maxwellmbooth/eeerover/board/age.png

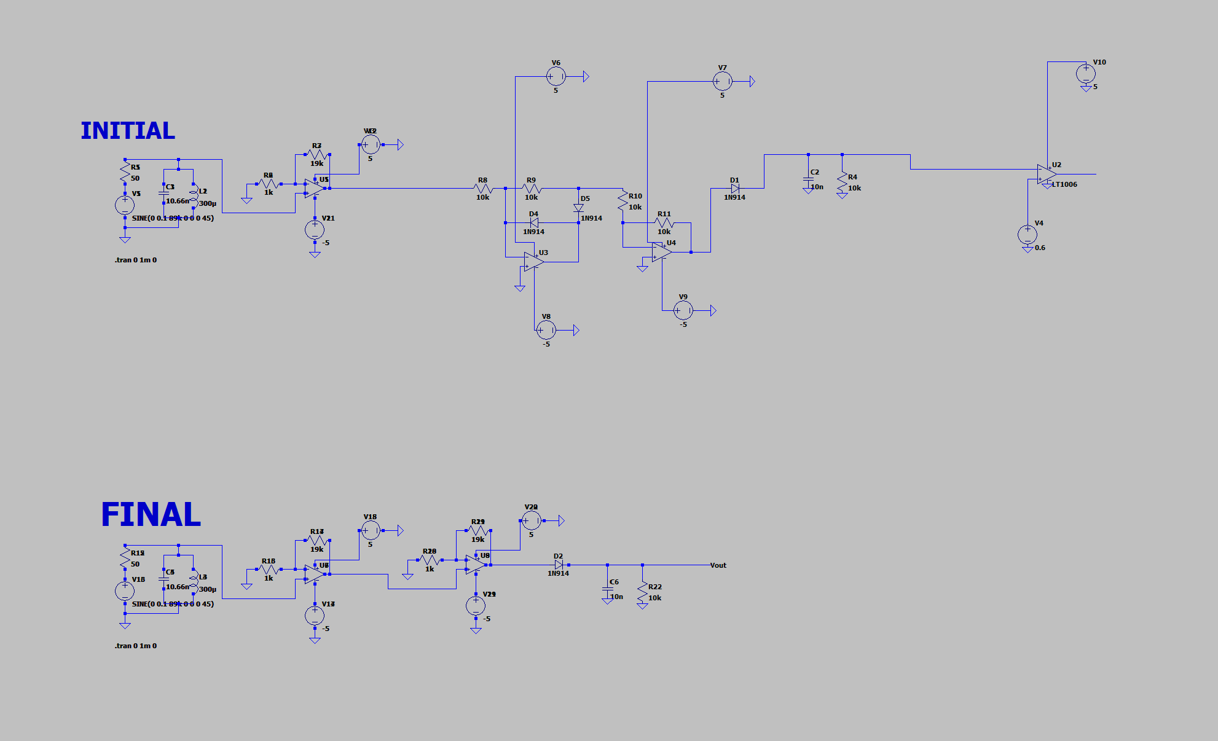
board/age.png
