maxwellmbooth/eeerover/board/ir.png

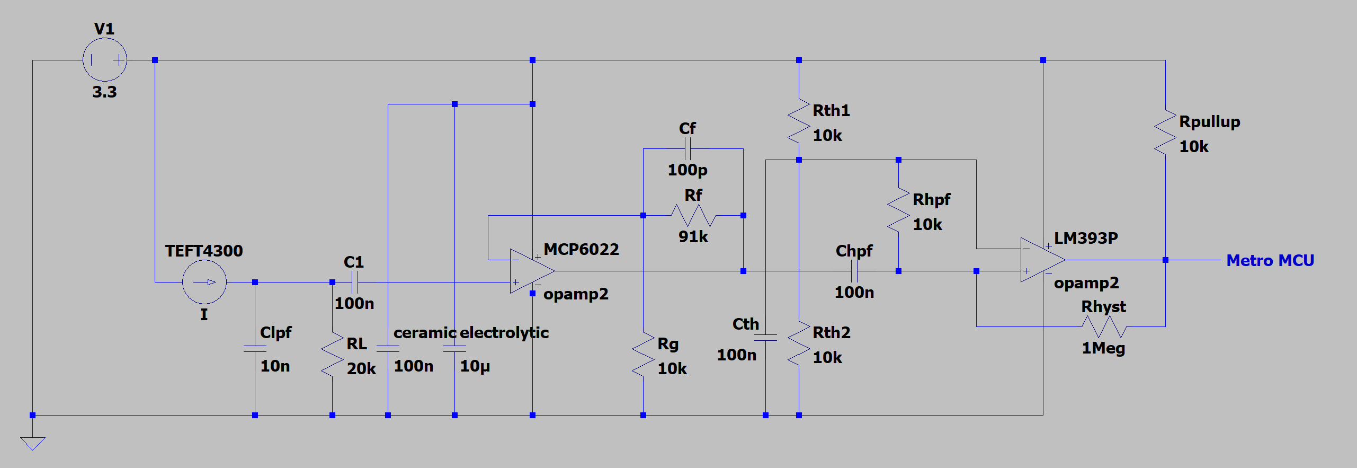
board/ir.png
