maxwellmbooth/eeerover/board/ultrasound.png

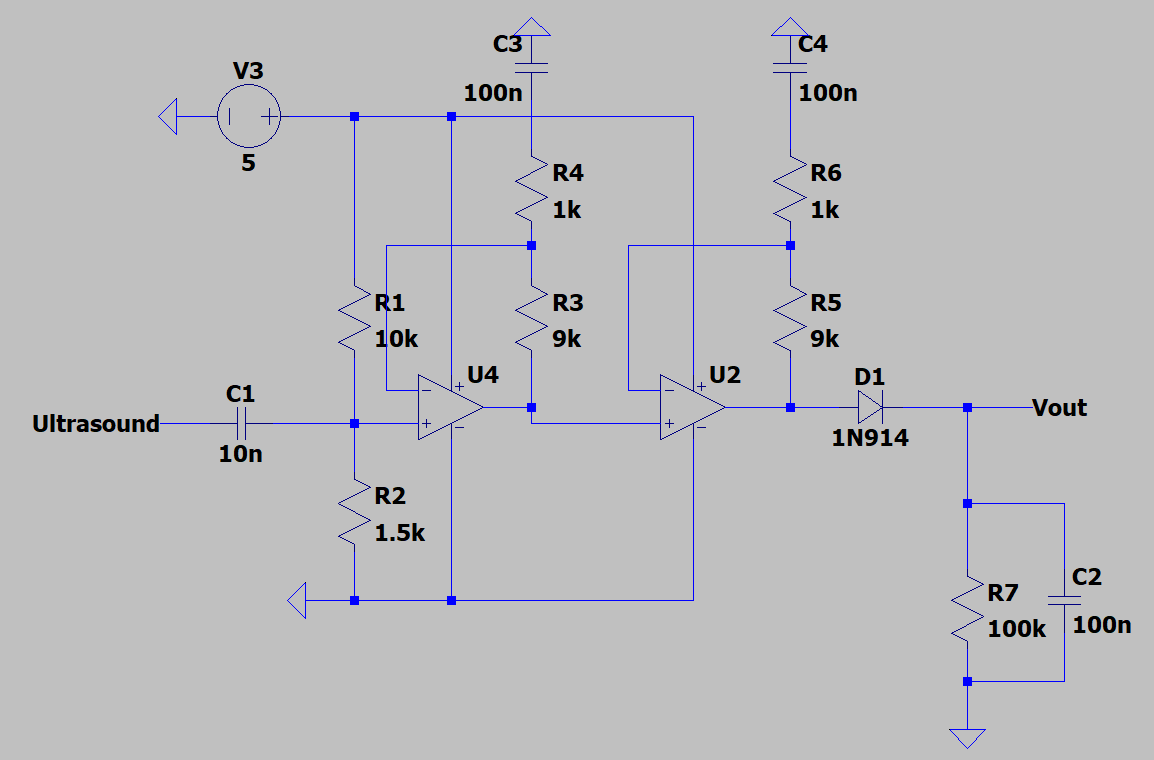
board/ultrasound.png
