maxwellmbooth/eeerover/board/3d/rover_pcb.step

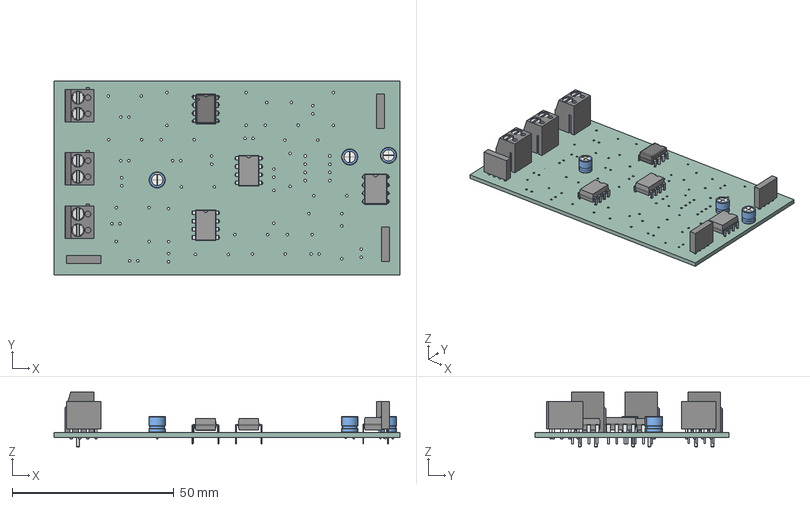
[picture p4: CAD file, 2026-06-10]
board/3d/rover_pcb.step
107.0 x 60.0 x 17.0 mm
CP_Radial_D50mm_P250mm x 3
BODY_P0008A
LEAD_P0008A x 4
LD_LHALF_P0008A x 2
LD_RHALF_P0008A x 2
CTB1202 2BK x 3
PinsArrayLR x 3
rover_PCB
