maxwellmbooth/eeerover/board/symbols/header1x4/2212S-04SG-85.stp

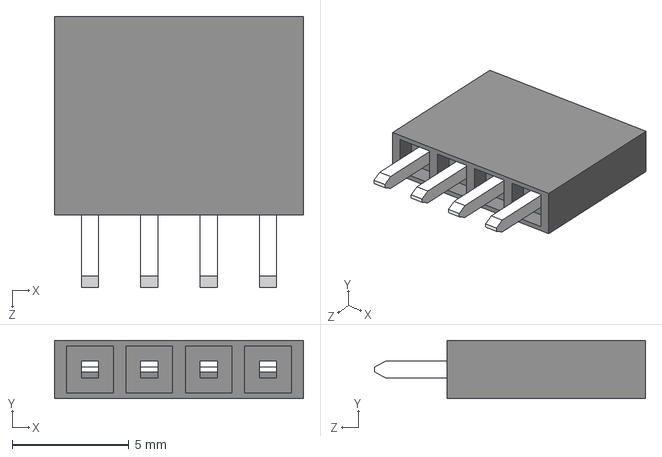
[picture p5: CAD file, 2026-06-10]
board/symbols/header1x4/2212S-04SG-85.stp
10.7 x 2.50 x 11.6 mm
