maxwellmbooth/eeerover/board/symbols/ICL7660CPA/ICL7660CPA+.stp

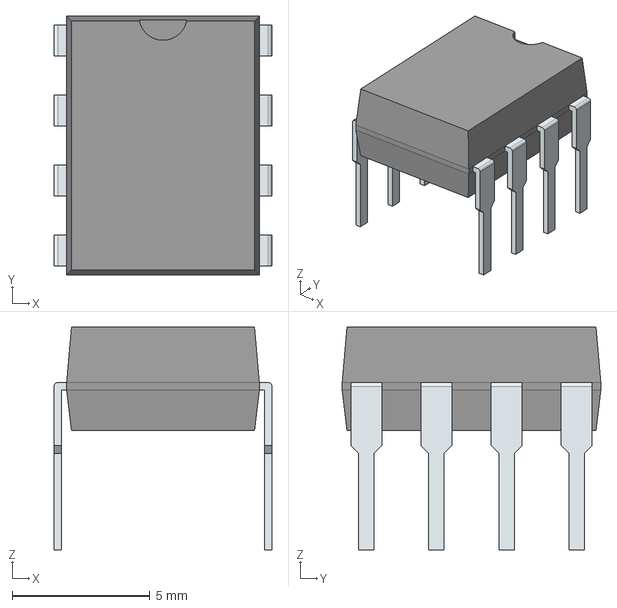
[picture p6: CAD file, 2026-06-10]
board/symbols/ICL7660CPA/ICL7660CPA+.stp
7.90 x 9.38 x 8.07 mm
PinsArrayLR
