maxwellmbooth/eeerover/board/symbols/LM393P/LM393P.stp

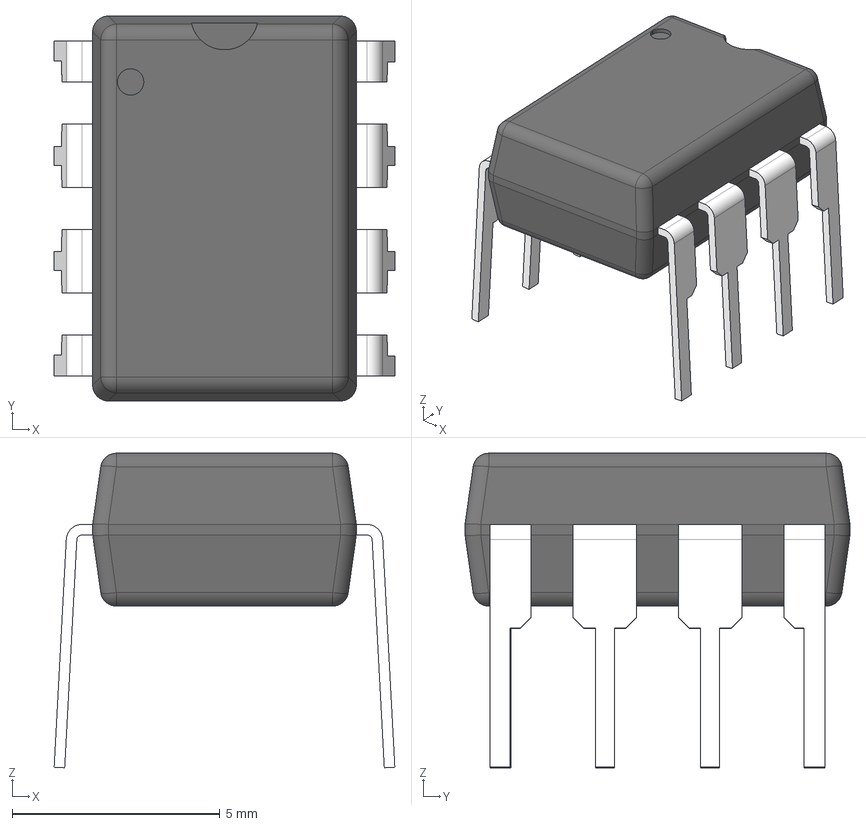
[picture p7: CAD file, 2026-06-10]
board/symbols/LM393P/LM393P.stp
8.20 x 9.27 x 7.58 mm
BODY_P0008A
LEAD_P0008A x 4
LD_LHALF_P0008A x 2
LD_RHALF_P0008A x 2
