maxwellmbooth/eeerover/board/symbols/MCP6022/MCP6022-I_P.stp

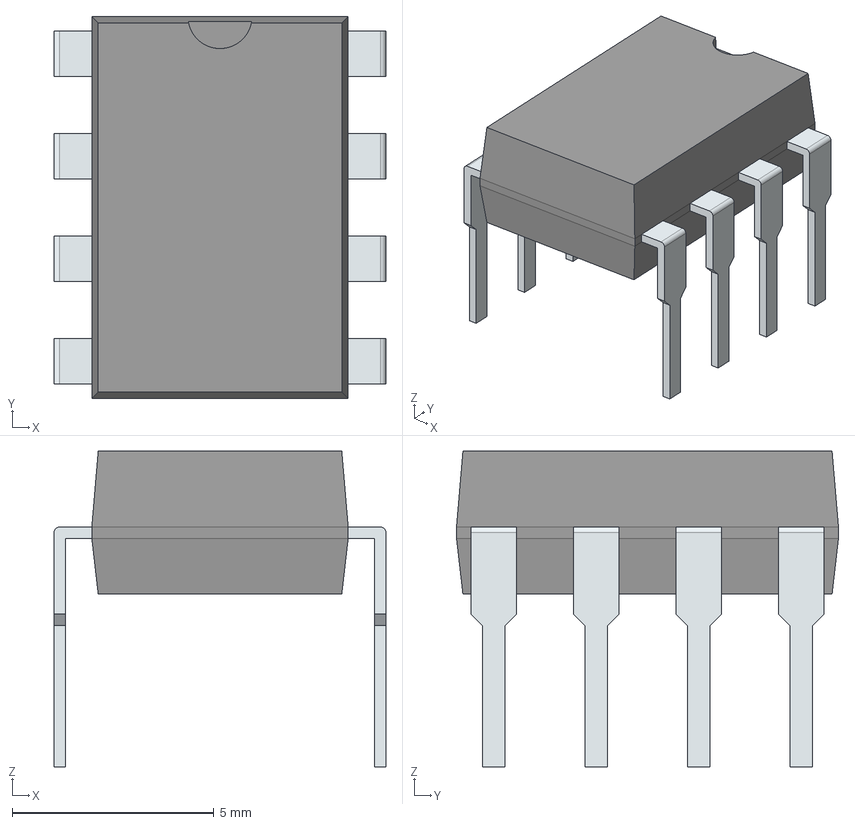
[picture p8: CAD file, 2026-06-10]
board/symbols/MCP6022/MCP6022-I_P.stp
8.22 x 9.46 x 7.82 mm
PinsArrayLR
