maxwellmbooth/eeerover/board/symbols/TerminalBlock/CTB1202_2BK.stp

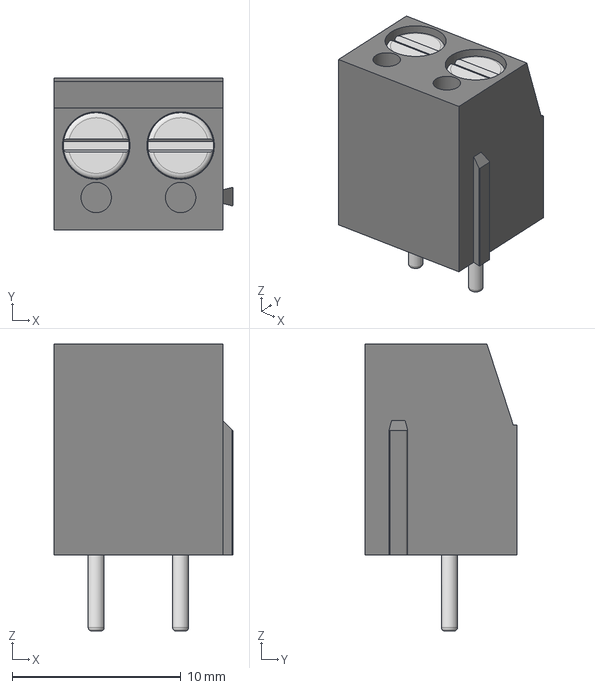
[picture p9: CAD file, 2026-06-10]
board/symbols/TerminalBlock/CTB1202_2BK.stp
10.6 x 9.00 x 17.0 mm
