maxwellmbooth/eeerover/cad/parts/arduino/arduino uno.SLDPRT

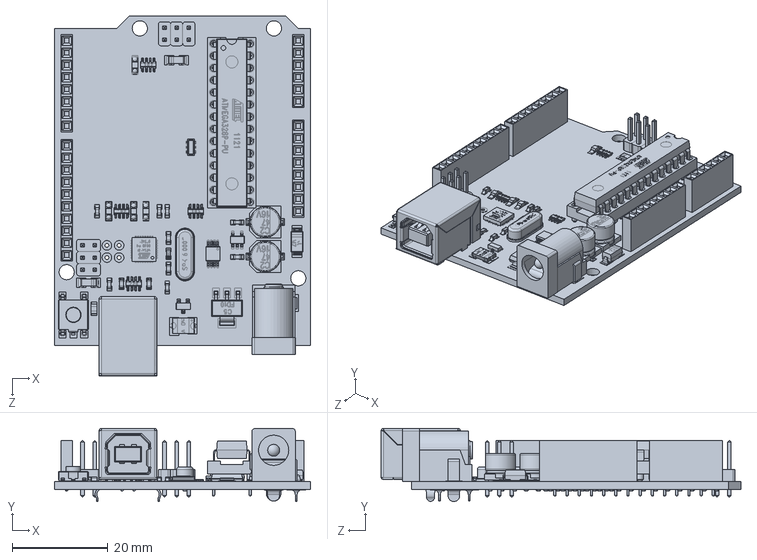
[picture p10: CAD file, 2026-06-10]
cad/parts/arduino/arduino uno.SLDPRT
53.3 x 15.2 x 74.9 mm
