maxwellmbooth/eeerover/cad/parts/eeebug-controller/eeebug.SLDPRT

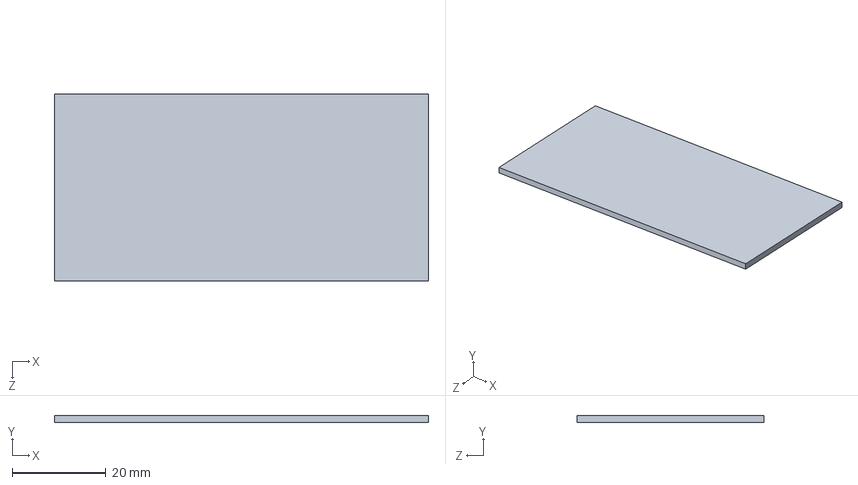
[picture p11: CAD file, 2026-06-16]
cad/parts/eeebug-controller/eeebug.SLDPRT
80.0 x 1.60 x 40.0 mm
