maxwellmbooth/eeerover/cad/parts/old_motor/motor.SLDPRT

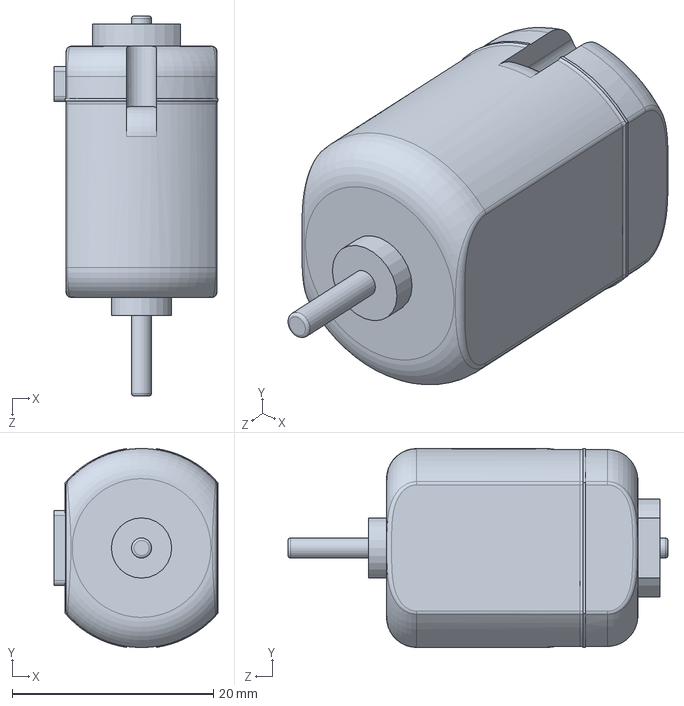
[picture p12: CAD file, 2026-06-10, an earlier design]
cad/parts/old_motor/motor.SLDPRT
16.3 x 19.8 x 37.8 mm
