maxwellmbooth/eeerover/cad/parts/old_motor/Gearbox.SLDPRT

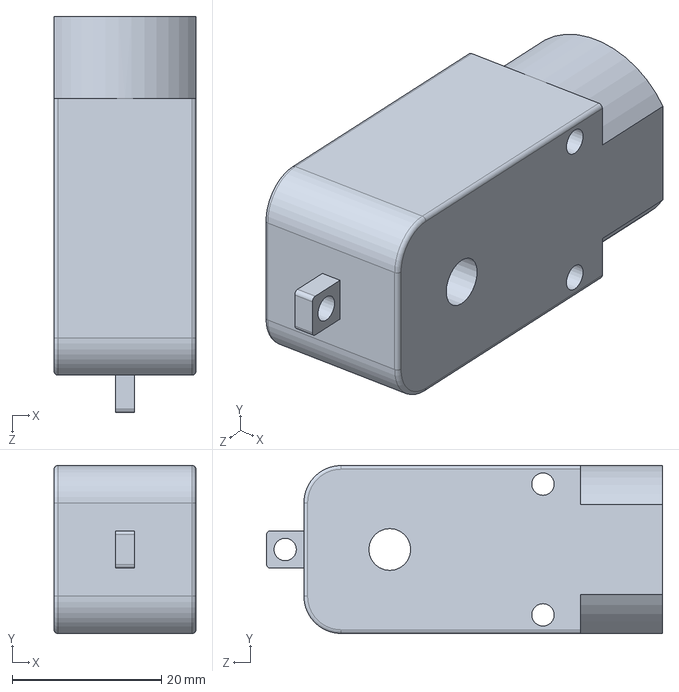
[picture p13: CAD file, 2026-06-10, an earlier design]
cad/parts/old_motor/Gearbox.SLDPRT
19.0 x 22.5 x 53.0 mm
