maxwellmbooth/eeerover/cad/parts/old_motor/output shaft.SLDPRT

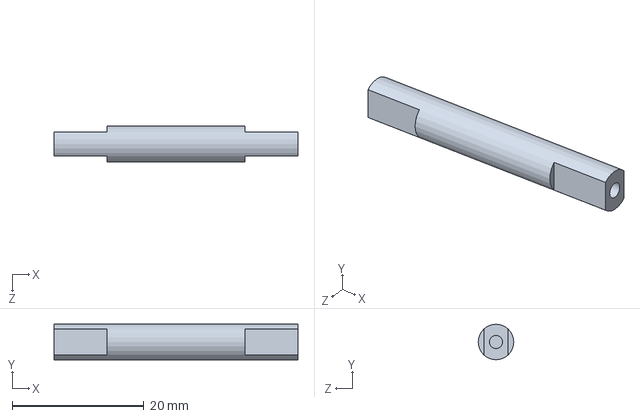
[picture p14: CAD file, 2026-06-10, an earlier design]
cad/parts/old_motor/output shaft.SLDPRT
37.0 x 5.40 x 5.40 mm
