maxwellmbooth/eeerover/cad/parts/old_motor/DC Motor Gearbox.STEP

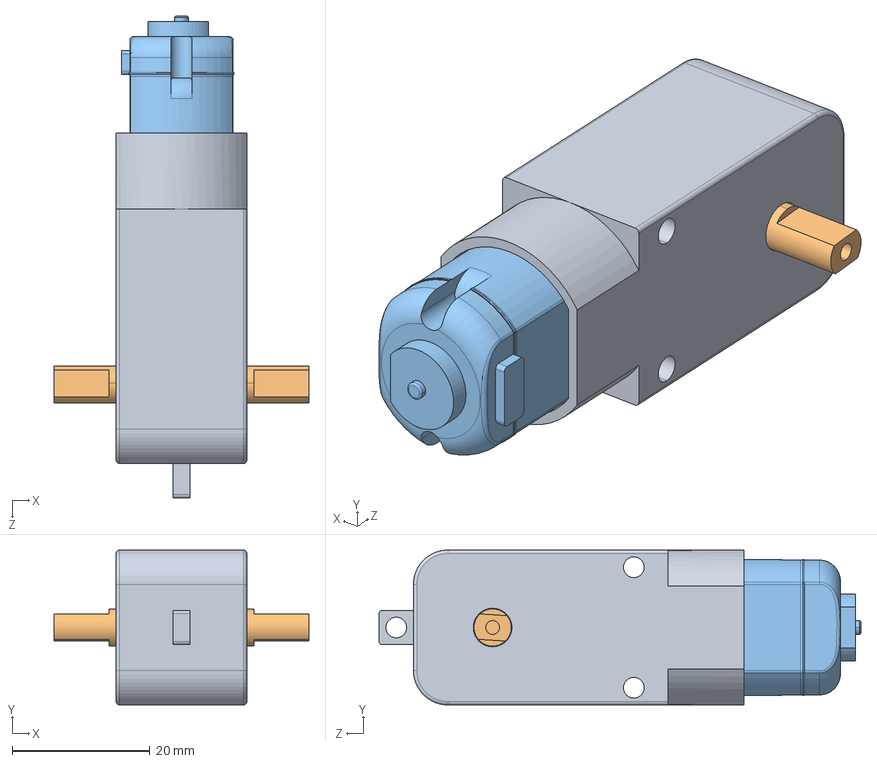
[picture p15: CAD file, 2026-06-03, an earlier design]
cad/parts/old_motor/DC Motor Gearbox.STEP
37.0 x 22.5 x 70.0 mm
Gearbox
output shaft
motor
