maxwellmbooth/eeerover/cad/rover.SLDASM

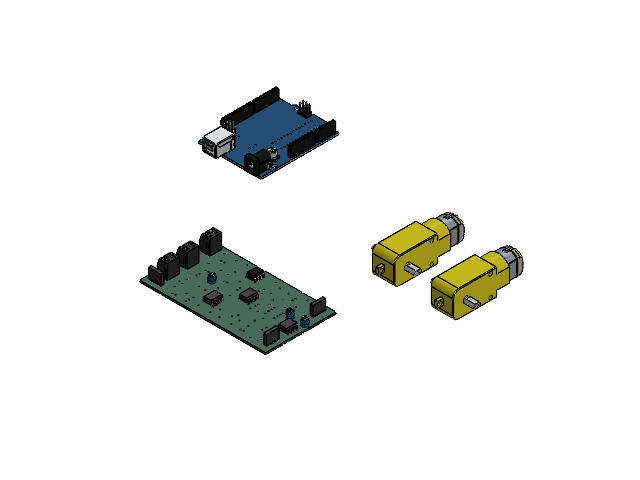
[picture p16: CAD file, 2026-06-16]
cad/rover.SLDASM
Gearbox x 2
output shaft x 2
motor x 2
CP_Radial_D50mm_P250mm.step x 3
BODY_P0008A.step
LEAD_P0008A.step x 4
LD_LHALF_P0008A.step x 2
LD_RHALF_P0008A.step x 2
Part123456.step x 3
CTB1202 2BK.step x 3
Body.step
PinsArrayLR.step
Body-0.step x 2
PinsArrayLR-1.step x 2
rover_PCB_1.step
arduino uno
