maxwellmbooth/eeerover/(list of files, cad)

Other CAD files:
cad/parts/chassis/chassis.SLDPRT
cad/parts/old_motor/DC Motor Gearbox.SLDASM
