maxwellmbooth/eeerover/board/rover/rover.kicad_pcb

## KiCad design board/rover/rover.kicad_pcb (2026-06-10)

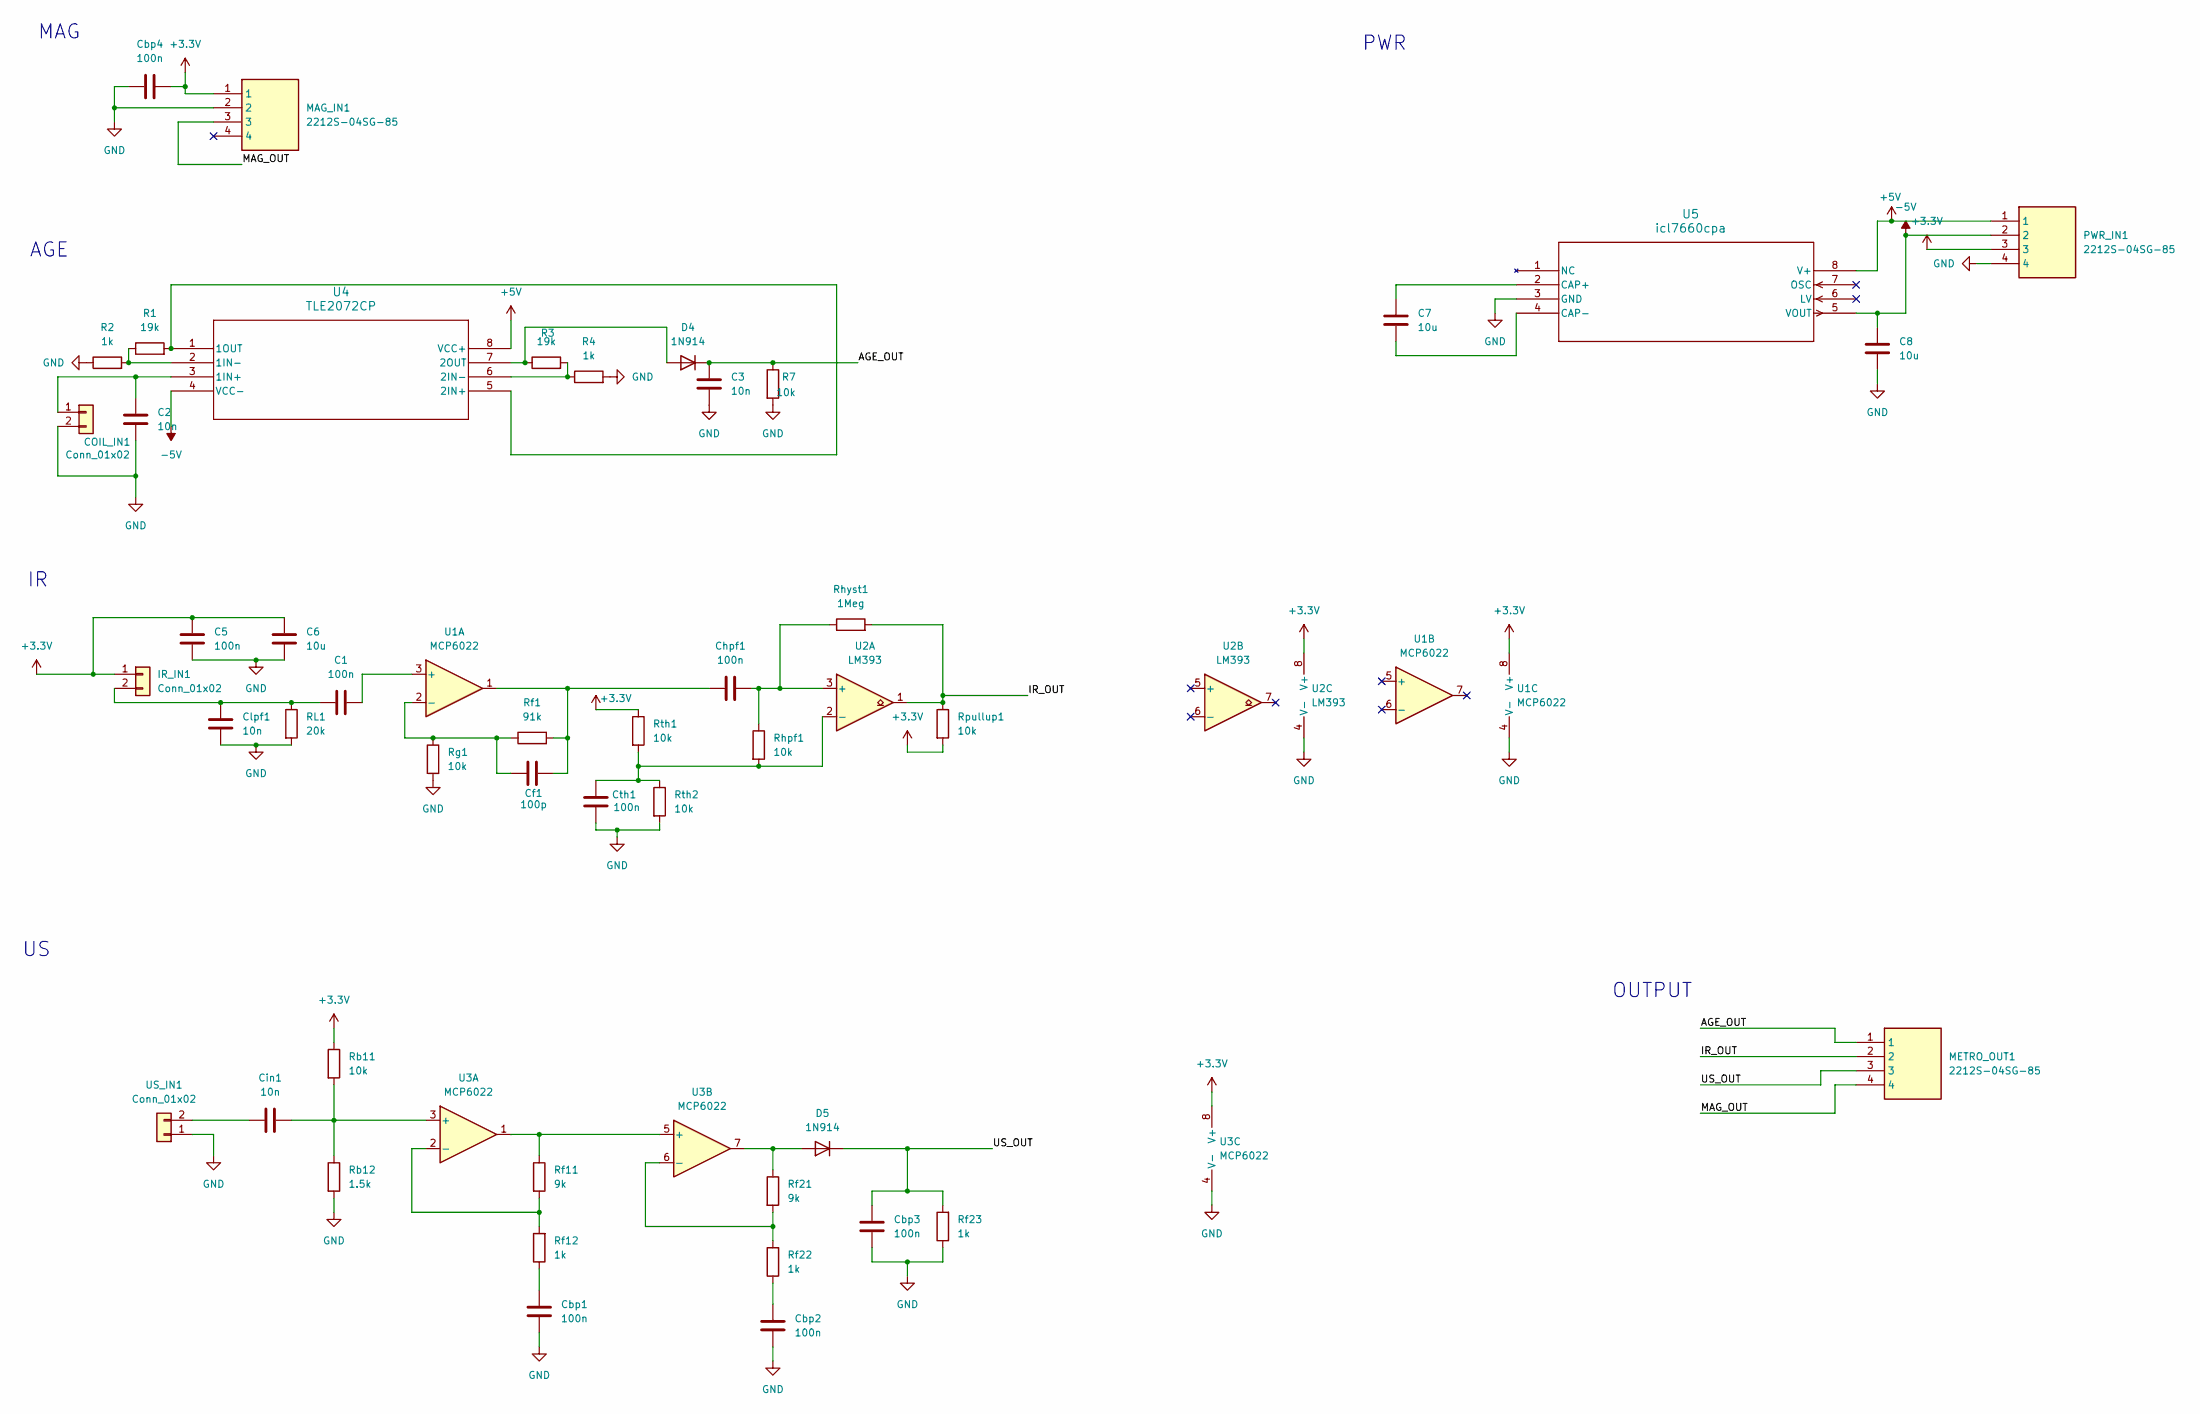
[picture p17: schematic rover.kicad_sch]

Parts:
C1, C5: 100n; C_Disc_D5.0mm_W2.5mm_P2.50mm
C2, C3: 10n; C_Disc_D5.0mm_W2.5mm_P2.50mm
C6, C7, C8: 10u; CP_Radial_D5.0mm_P2.50mm
COIL_IN1: Conn_01x02; TerminalBlock_MaiXu_MX126-5.0-02P_1x02_P5.00mm
Cbp1, Cbp2, Cbp3, Cbp4: 100n; C_Disc_D5.0mm_W2.5mm_P2.50mm
Cf1: 100p; C_Disc_D5.0mm_W2.5mm_P2.50mm
Chpf1: 100n; C_Disc_D5.0mm_W2.5mm_P2.50mm
Cin1: 10n; C_Disc_D5.0mm_W2.5mm_P2.50mm
Clpf1: 10n; C_Disc_D5.0mm_W2.5mm_P2.50mm
Cth1: 100n; C_Disc_D5.0mm_W2.5mm_P2.50mm
D4, D5: 1N914; D_DO-35_SOD27_P7.62mm_Horizontal
IR_IN1: Conn_01x02; TerminalBlock_MaiXu_MX126-5.0-02P_1x02_P5.00mm
MAG_IN1: 2212S-04SG-85; 2212S04SG85; Manufacturer_Part_Number 2212S-04SG-85
METRO_OUT1: 2212S-04SG-85; 2212S04SG85; Manufacturer_Part_Number 2212S-04SG-85
PWR_IN1: 2212S-04SG-85; 2212S04SG85; Manufacturer_Part_Number 2212S-04SG-85
R1, R3: 19k; R_Axial_DIN0207_L6.3mm_D2.5mm_P10.16mm_Horizontal
R2, R4: 1k; R_Axial_DIN0207_L6.3mm_D2.5mm_P10.16mm_Horizontal
R7: 10k; R_Axial_DIN0207_L6.3mm_D2.5mm_P10.16mm_Horizontal
RL1: 20k; R_Axial_DIN0207_L6.3mm_D2.5mm_P10.16mm_Horizontal
Rb11: 10k; R_Axial_DIN0207_L6.3mm_D2.5mm_P10.16mm_Horizontal
Rb12: 1.5k; R_Axial_DIN0207_L6.3mm_D2.5mm_P10.16mm_Horizontal
Rf1: 91k; R_Axial_DIN0207_L6.3mm_D2.5mm_P10.16mm_Horizontal
Rf11, Rf21: 9k; R_Axial_DIN0207_L6.3mm_D2.5mm_P10.16mm_Horizontal
Rf12, Rf22, Rf23: 1k; R_Axial_DIN0207_L6.3mm_D2.5mm_P10.16mm_Horizontal
Rg1: 10k; R_Axial_DIN0207_L6.3mm_D2.5mm_P10.16mm_Horizontal
Rhpf1: 10k; R_Axial_DIN0207_L6.3mm_D2.5mm_P10.16mm_Horizontal
Rhyst1: 1Meg; R_Axial_DIN0207_L6.3mm_D2.5mm_P10.16mm_Horizontal
Rpullup1: 10k; R_Axial_DIN0207_L6.3mm_D2.5mm_P10.16mm_Horizontal
Rth1, Rth2: 10k; R_Axial_DIN0207_L6.3mm_D2.5mm_P10.16mm_Horizontal
U1, U3: MCP6022; PDIP8_300MC_MCH
U2: LM393; P8
U4: TLE2072CP; P8
U5: icl7660cpa; 21-0043D_8_MXM
US_IN1: Conn_01x02; TerminalBlock_MaiXu_MX126-5.0-02P_1x02_P5.00mm

Connections:
+3.3V: C5.1, C6.1, Cbp4.2, IR_IN1.1, MAG_IN1.1, PWR_IN1.3, Rb11.1, Rpullup1.2, Rth1.1, U1.8 (V+), U2.8 (V+), U3.8 (V+)
+5V: PWR_IN1.1, U4.8 (VCC+), U5.8 (V+)
-5V: C8.1, PWR_IN1.2, U4.4 (VCC-), U5.5 (VOUT)
/AGE_OUT: C3.1, D4.1 (K), METRO_OUT1.1, R7.1
/IR_OUT: METRO_OUT1.2, Rhyst1.2, Rpullup1.1, U2.1
/MAG_OUT: MAG_IN1.3, METRO_OUT1.4
/US_OUT: Cbp3.1, D5.1 (K), METRO_OUT1.3, Rf23.2
GND: C2.2, C3.2, C5.2, C6.2, C8.2, COIL_IN1.2, Cbp1.2, Cbp2.2, Cbp3.2, Cbp4.1, Clpf1.2, Cth1.2, MAG_IN1.2, PWR_IN1.4, R2.1, R4.2, R7.2, RL1.2, Rb12.2, Rf23.1, Rg1.2, Rth2.2, U1.4 (V-), U2.4 (V-), U3.4 (V-), U5.3 (GND), US_IN1.1
unnamed: C2.1, COIL_IN1.1, U4.3 (1IN+)
unnamed: Cbp1.1, Rf12.1
unnamed: Cbp2.1, Rf22.1
unnamed: Cf1.2, Chpf1.1, Rf1.2, U1.1
unnamed: D4.2 (A), R3.1, U4.7 (2OUT)
unnamed: D5.2 (A), Rf21.1, U3.7
unnamed: C1.1, Clpf1.1, IR_IN1.2, RL1.1
unnamed: C1.2, U1.3 (+)
unnamed: Cf1.1, Rf1.1, Rg1.1, U1.2 (-)
unnamed: Chpf1.2, Rhpf1.1, Rhyst1.1, U2.3 (+)
unnamed: Cth1.1, Rhpf1.2, Rth1.2, Rth2.1, U2.2 (-)
unnamed: Cin1.1, Rb11.2, Rb12.1, U3.3 (+)
unnamed: Rf11.2, Rf12.2, U3.2 (-)
unnamed: Rf11.1, U3.1, U3.5 (+)
unnamed: Rf21.2, Rf22.2, U3.6 (-)
unnamed: R1.1, R2.2, U4.2 (1IN-)
unnamed: R1.2, U4.1 (1OUT), U4.5 (2IN+)
unnamed: R3.2, R4.1, U4.6 (2IN-)
unnamed: C7.1, U5.2 (CAP+)
unnamed: C7.2, U5.4 (CAP-)
unnamed: Cin1.2, US_IN1.2

Notes on the sheet:
PWR
AGE
OUTPUT
MAG

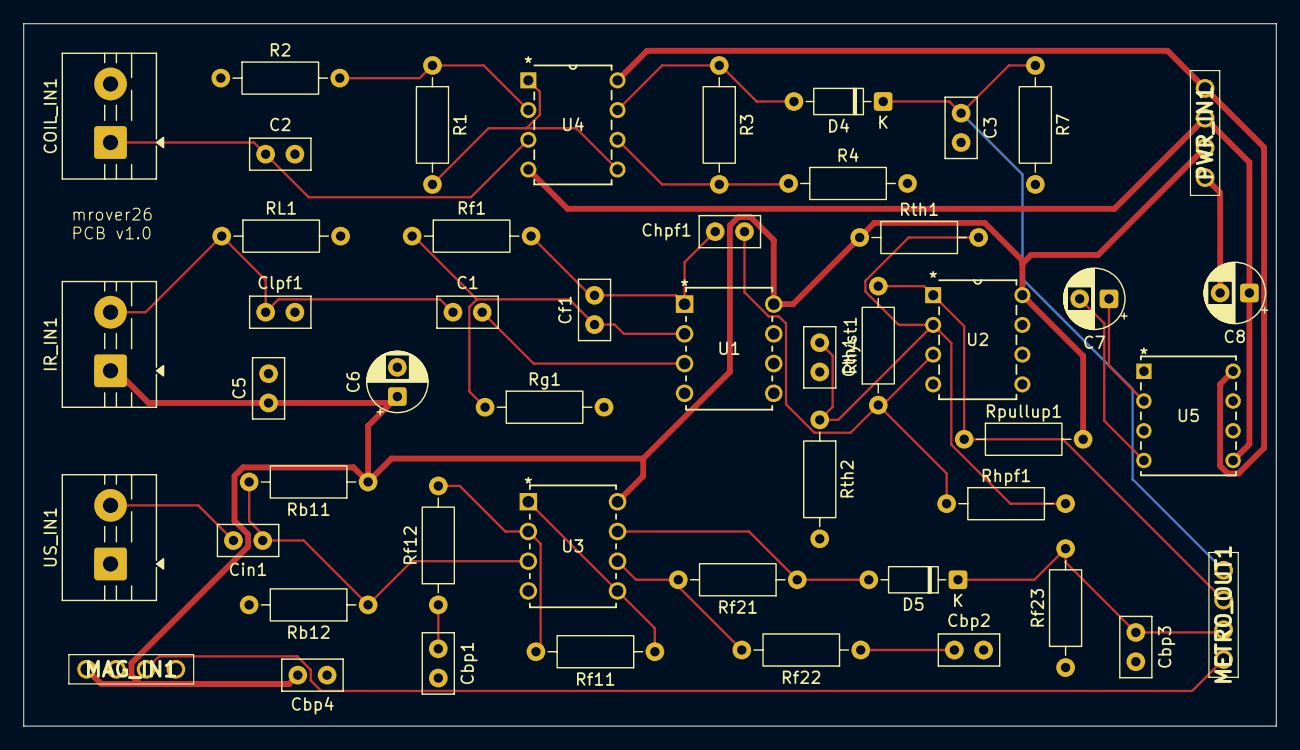
[picture p18: board rover.kicad_pcb from above]

Board: 2 copper layers, 107.0 x 60.0 mm, 49 parts (0 on the bottom side), 29 nets.
