maxwellmbooth/eeerover/(commit log)

2026-05-19 Final commit to double arduino idea.
2026-05-19 Final commit to double arduino idea
2026-05-28 Added bidirectional UDP support and started PCB design
    [rover.kicad_pcb, rover.kicad_sch]
2026-06-03 Merged IR code
    [DC Motor Gearbox.SLDASM, DC Motor Gearbox.STEP, Gearbox.SLDPRT, chassis.SLDPRT, motor.SLDPRT, output shaft.SLDPRT]
2026-06-03 Changed UDP print to write
2026-06-04 Finished PCB
    [rover.kicad_pcb, rover.kicad_sch]
2026-06-05 Added -5V generation to PCB
    [rover-B_Cu.gbr, rover-B_Mask.gbr, rover-B_Paste.gbr, rover-B_Silkscreen.gbr, rover-Edge_Cuts.gbr, rover-F_Cu.gbr, rover-F_Mask.gbr, rover-F_Paste.gbr]
2026-06-10 Finished merging rover-side code and made small changes to app
    [2212S-04SG-85.stp, CTB1202_2BK.stp, DC Motor Gearbox.SLDASM, Gearbox.SLDPRT, ICL7660CPA+.stp, LM393P.stp, MCP6022-I_P.stp, TLE2072CP.stp]
2026-06-10 Added UDP reset and auto-reset and fixed transmission bugs.
    [main.cpp]
2026-06-16 Changed thresholds and added rock type panel in app
    [chassis.SLDPRT, eeebug.SLDPRT, rover.SLDASM, rover.csv, rover.kicad_sch]
